dakodako/Group/README.md

# Group

#meeting links

板
https://item.taobao.com/item.htm?id=25225744375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

图像传感器模块
https://item.taobao.com/item.htm?spm=2013.1.0.0.4AKXVt&id=532988877099&ali_refid=a3_430582_1006:1109264529:N:
