dakodako/Group/ESI_WS2.docx

10HZ 9600 Baud rate

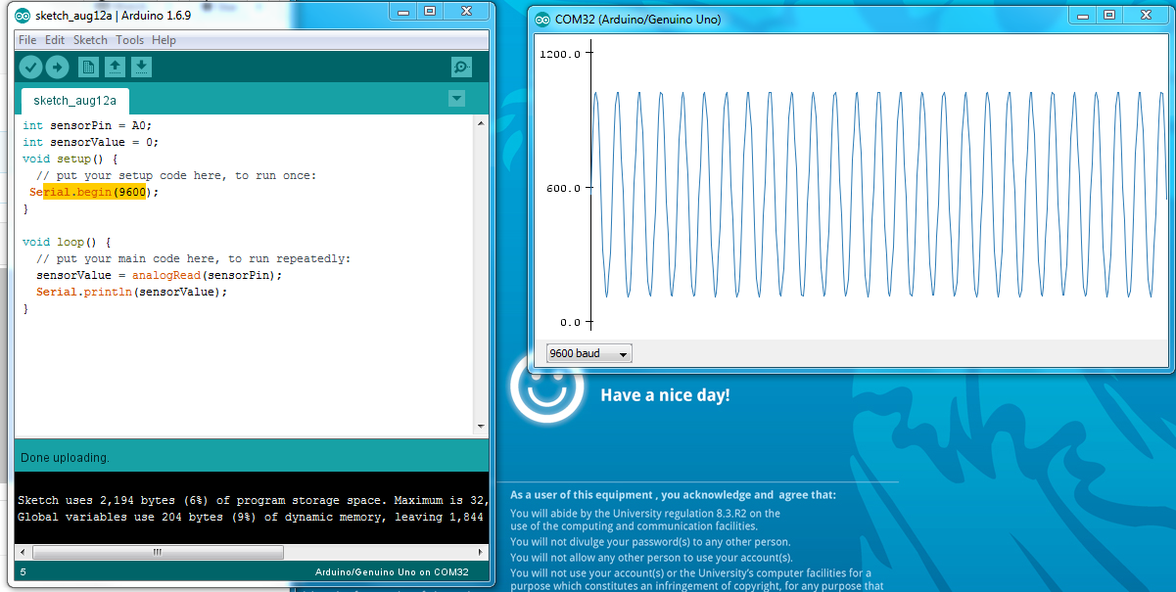
[picture p12: figure]

Function generator increase to 100HZ

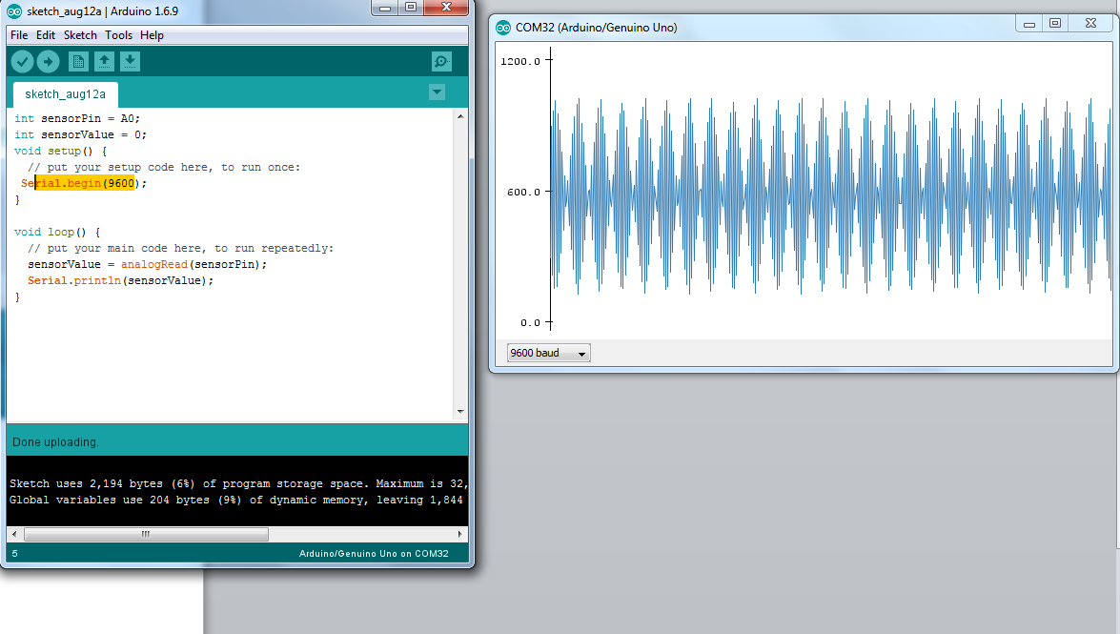
[picture p13: figure]

The plot is becoming inaccurate because the signal has a higher frequency than the resolution

100HZ+115200+4.5_0.5

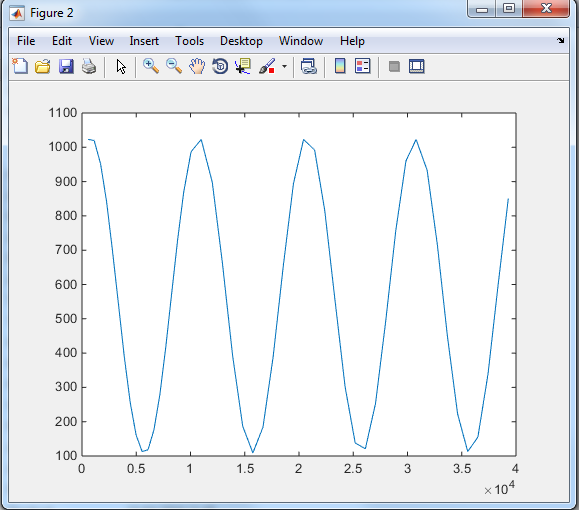
[picture p14: figure]

115200+10HZ+2.05-2.00

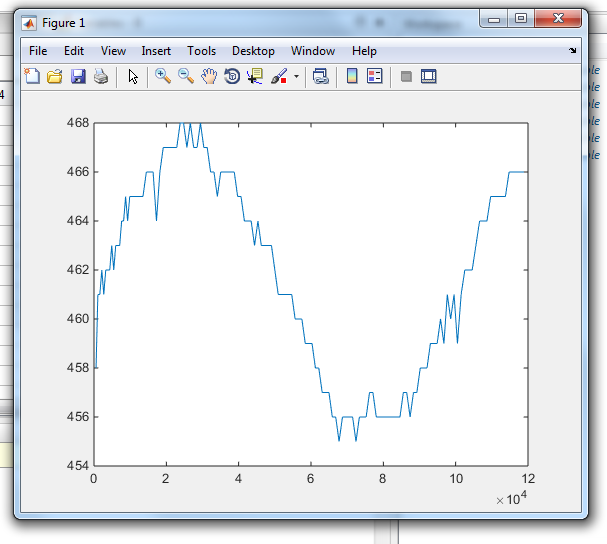
[picture p15: figure]
