dakodako/Group/screen_shots_pdf/workshop5.pdf

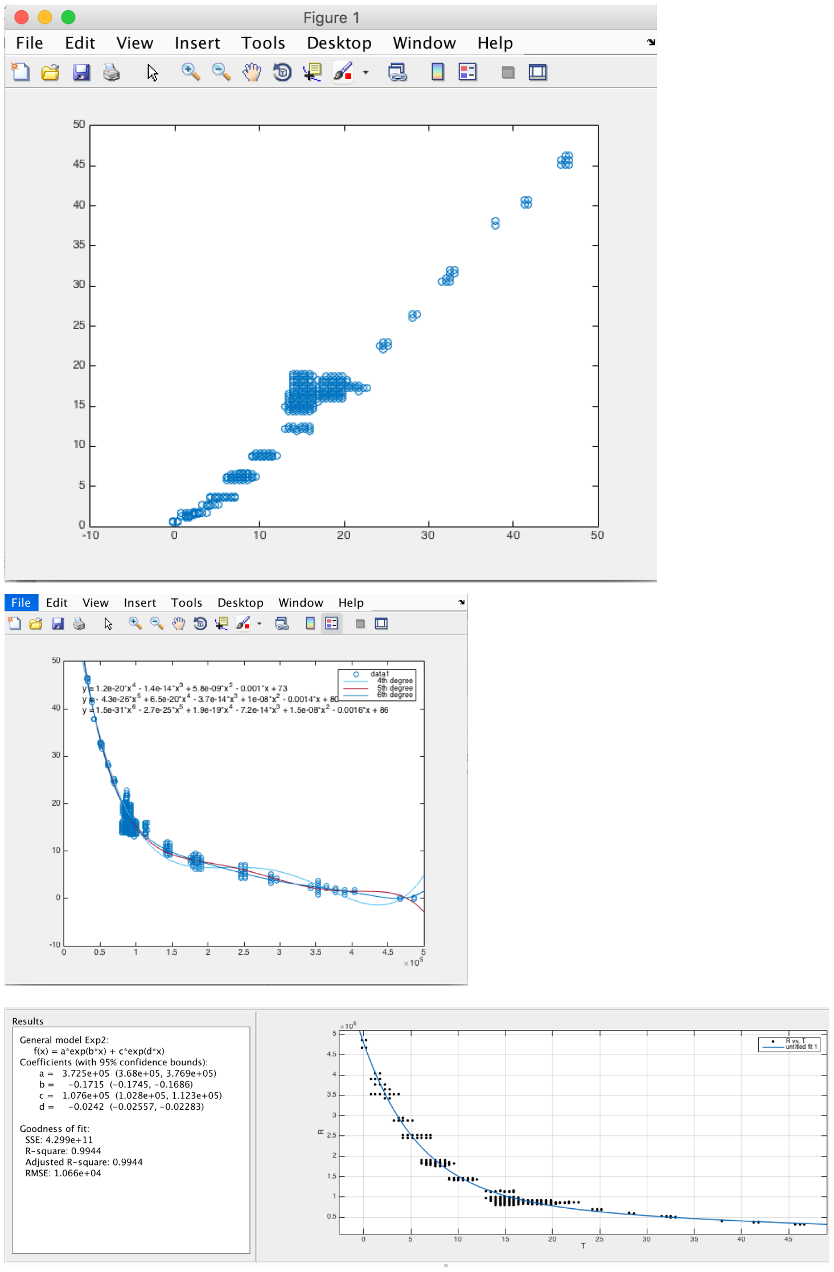
[picture p16: page 1]
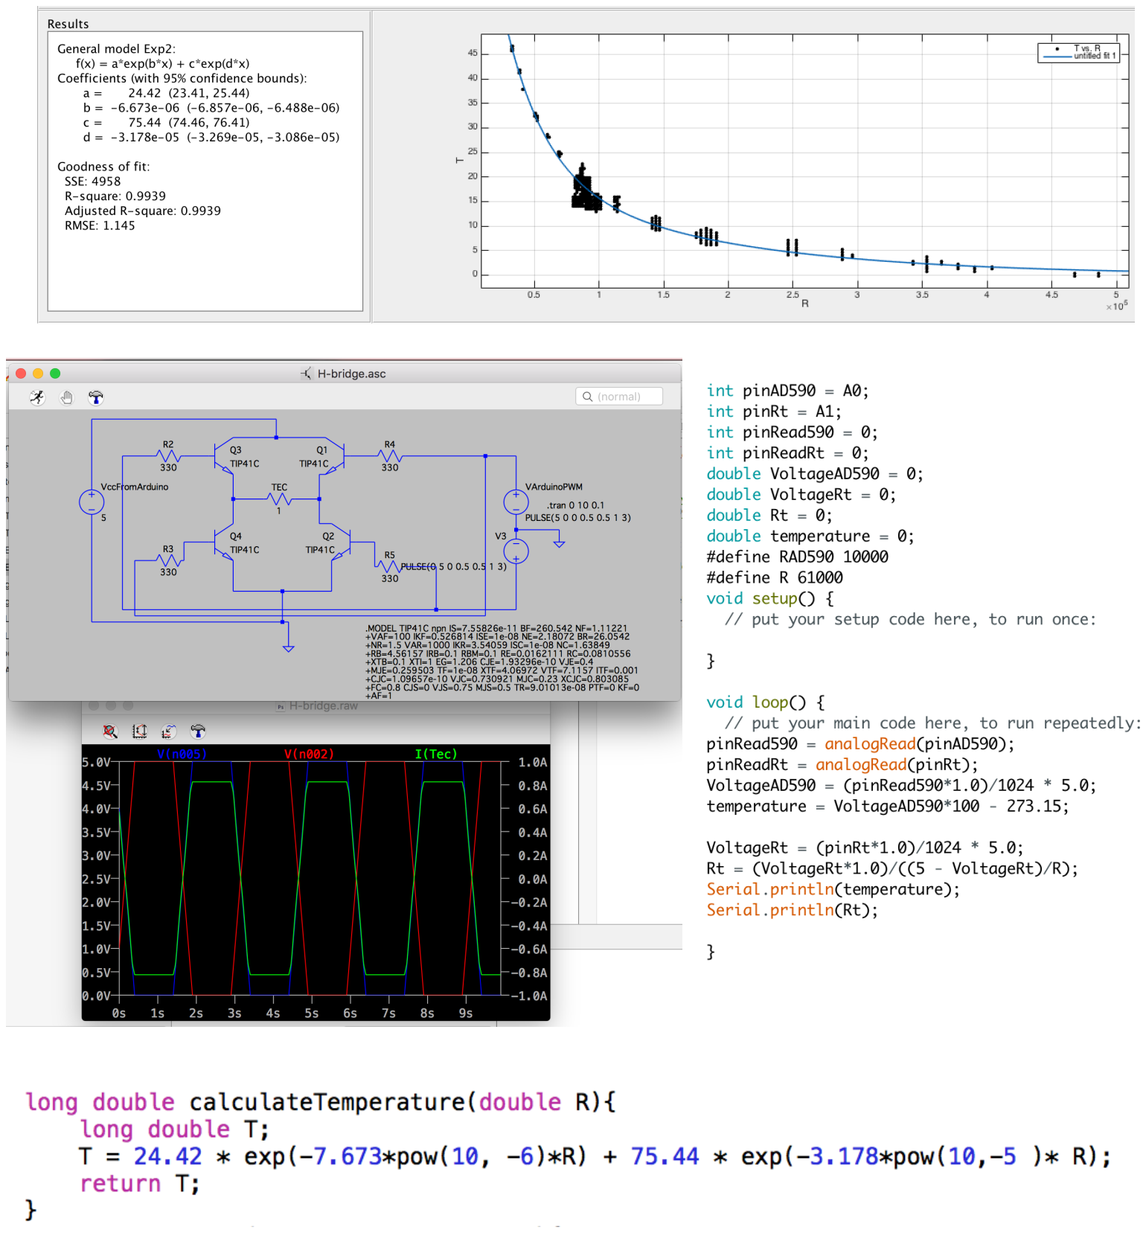
[picture p17: page 2]
