dakodako/Group/2_signal_conditioning/fit/cool_down.PNG

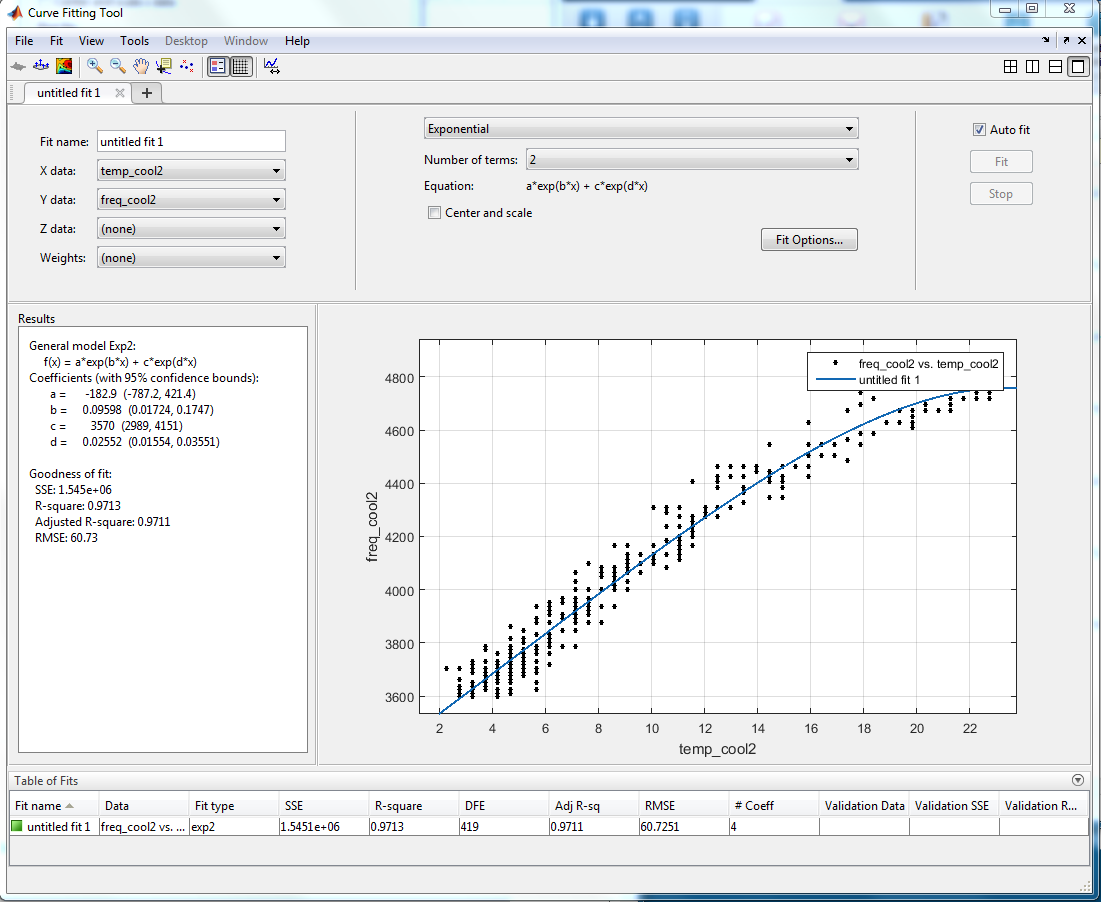
2_signal_conditioning/fit/cool_down.PNG
