dakodako/Group/2_signal_conditioning/fit/cool_down_basic.PNG

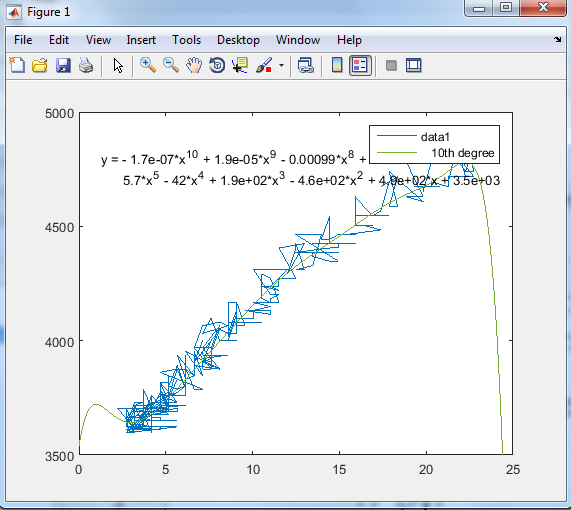
2_signal_conditioning/fit/cool_down_basic.PNG
