dakodako/Group/2_signal_conditioning/fit/heat_up.PNG

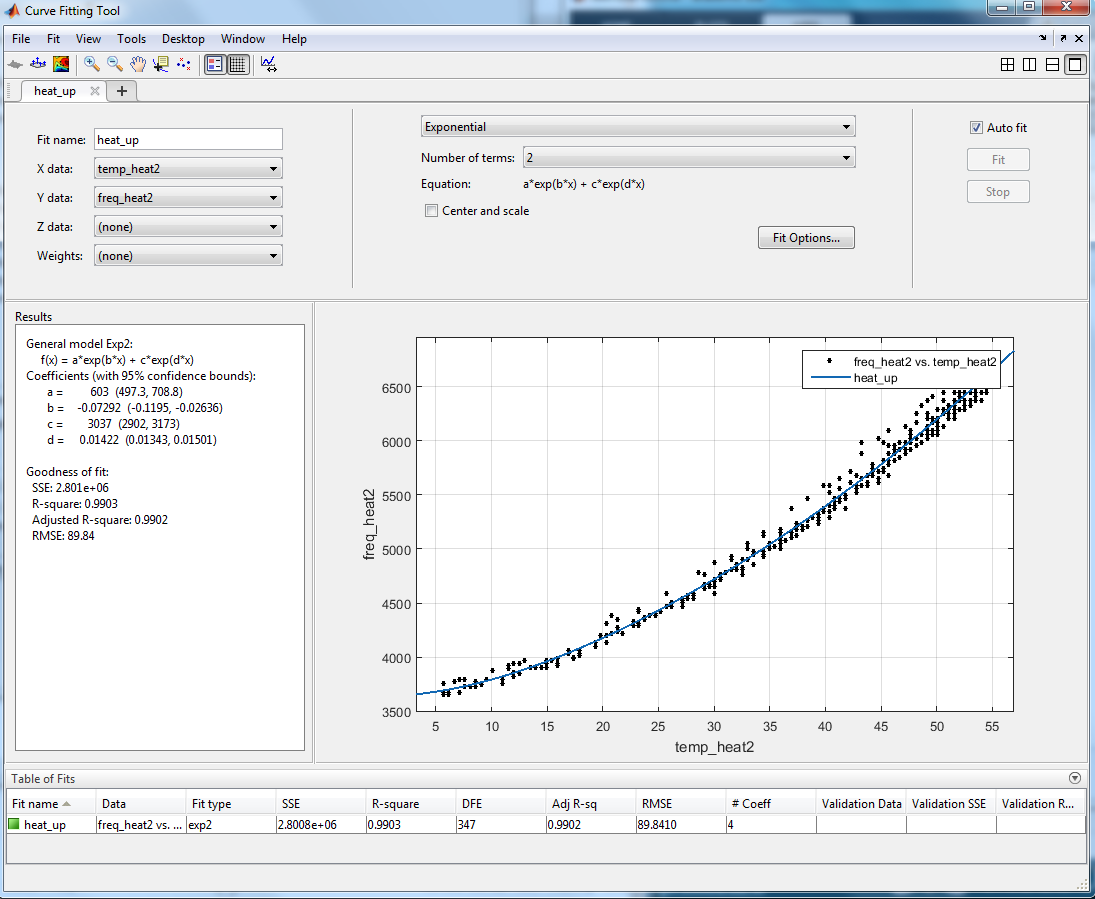
2_signal_conditioning/fit/heat_up.PNG
