dakodako/Group/2_signal_conditioning/fit/heat_up_basic.PNG

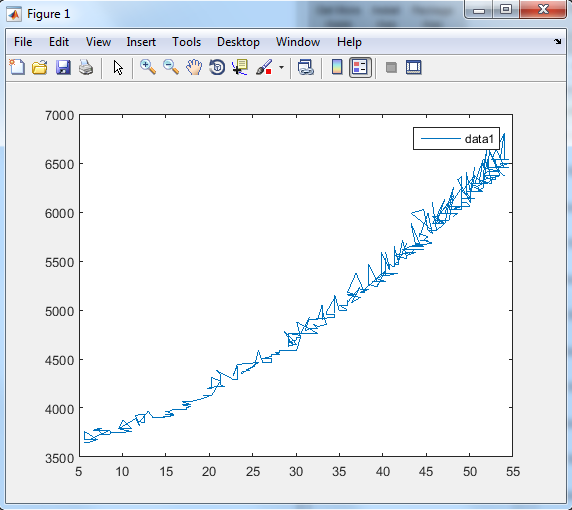
2_signal_conditioning/fit/heat_up_basic.PNG
