dakodako/Group/presentation/ESI_presentation/14793860_10211154600847782_1443315126_n.jpg

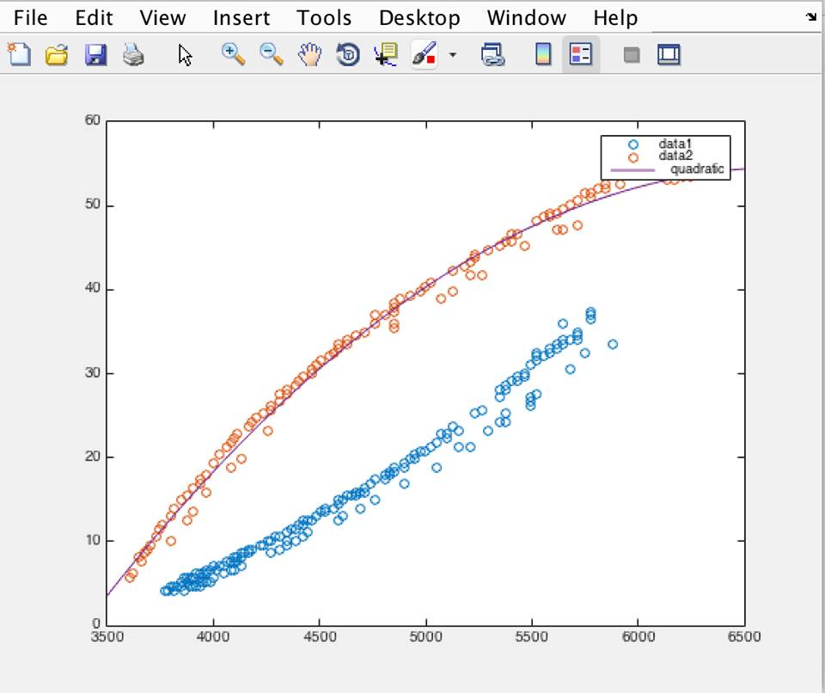
presentation/ESI_presentation/14793860_10211154600847782_1443315126_n.jpg
