dakodako/Group/Screen Shot 2016-09-03 at 10.55.11 PM.png

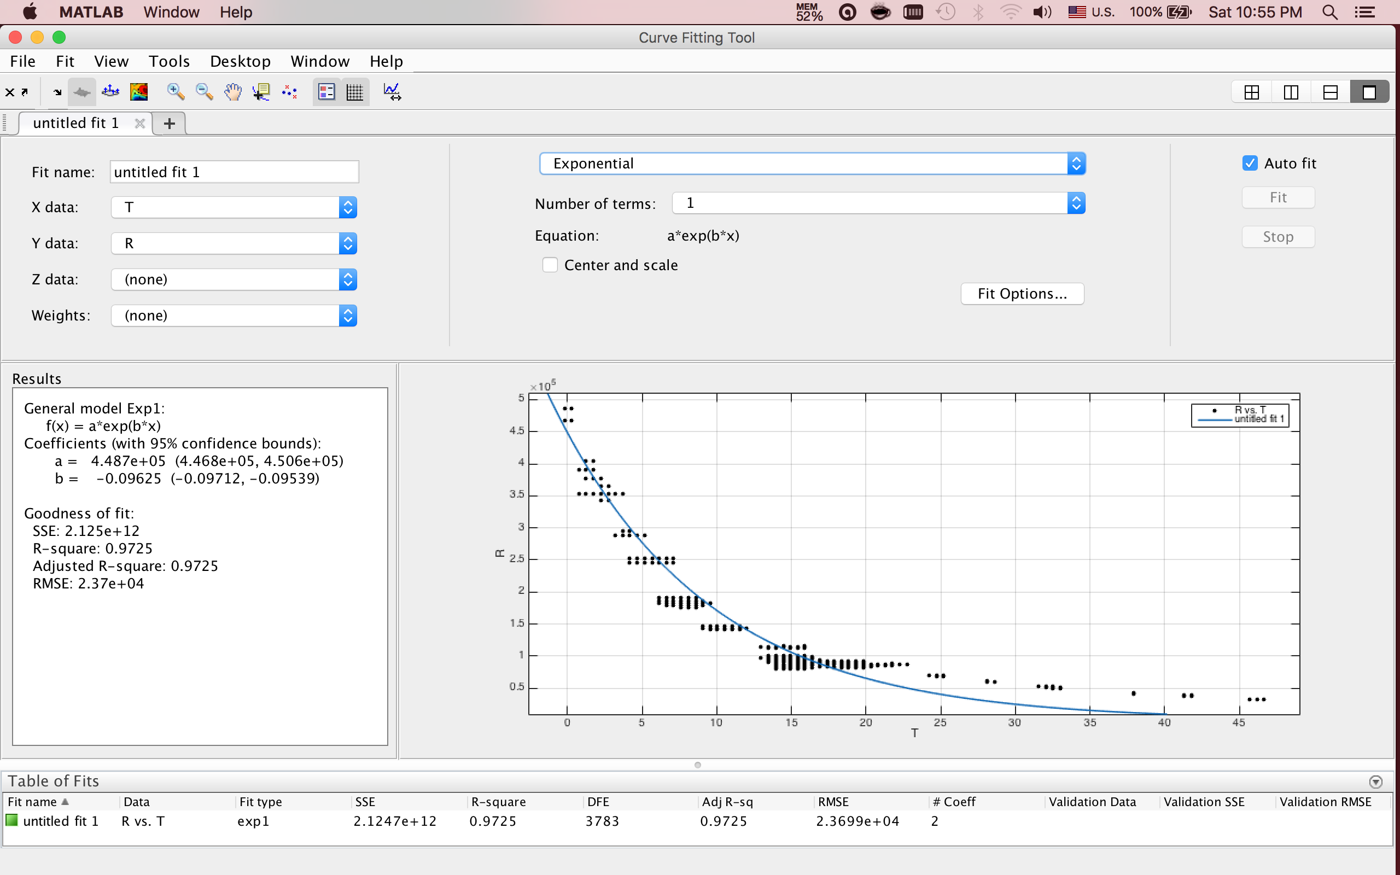
Screen Shot 2016-09-03 at 10.55.11 PM.png
