dakodako/Group/Screen Shot 2016-09-07 at 10.08.42 PM.png

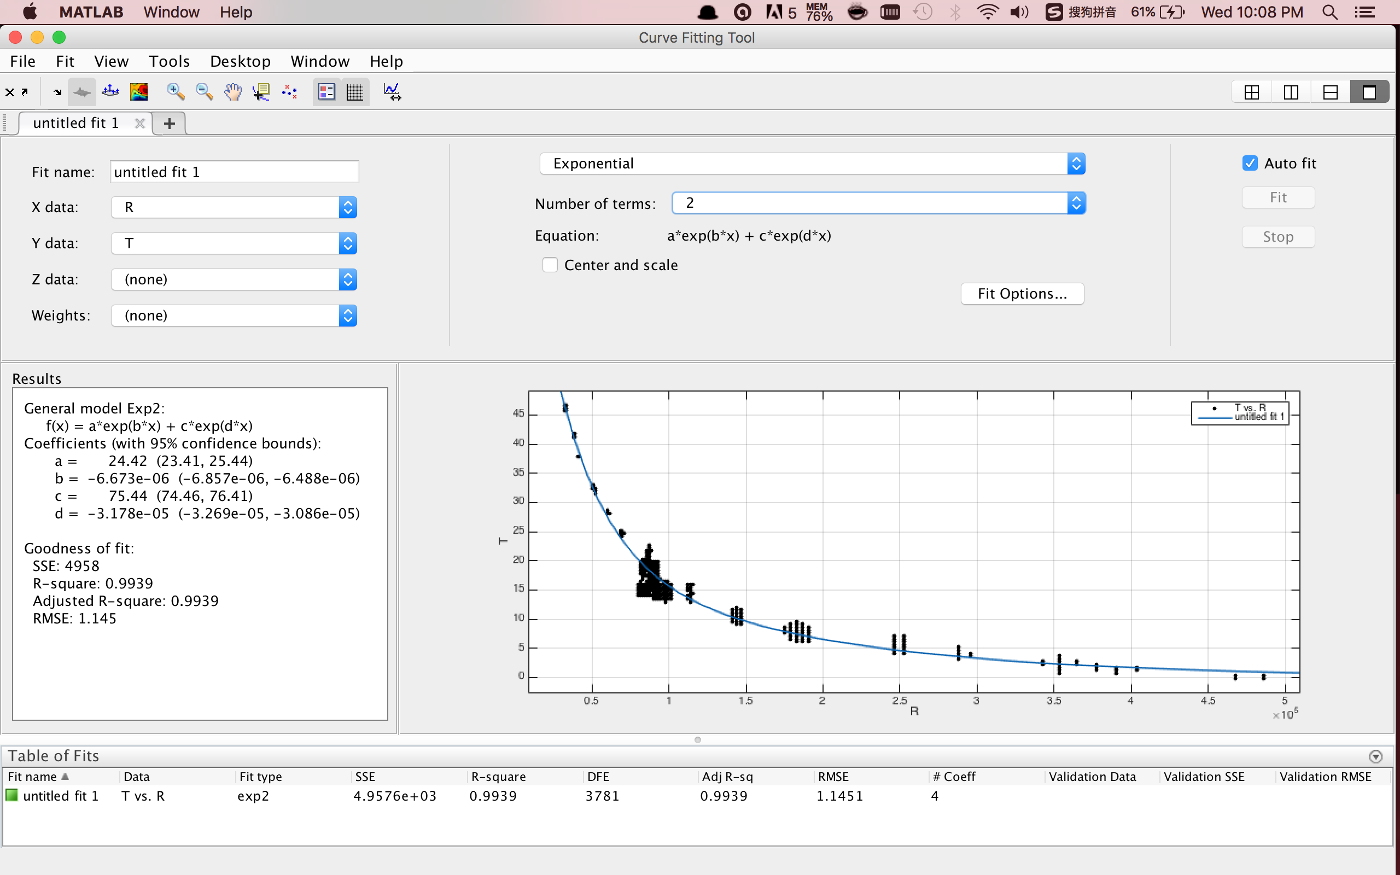
Screen Shot 2016-09-07 at 10.08.42 PM.png
