dakodako/Group/Screen Shot 2016-09-07 at 10.41.13 PM.png

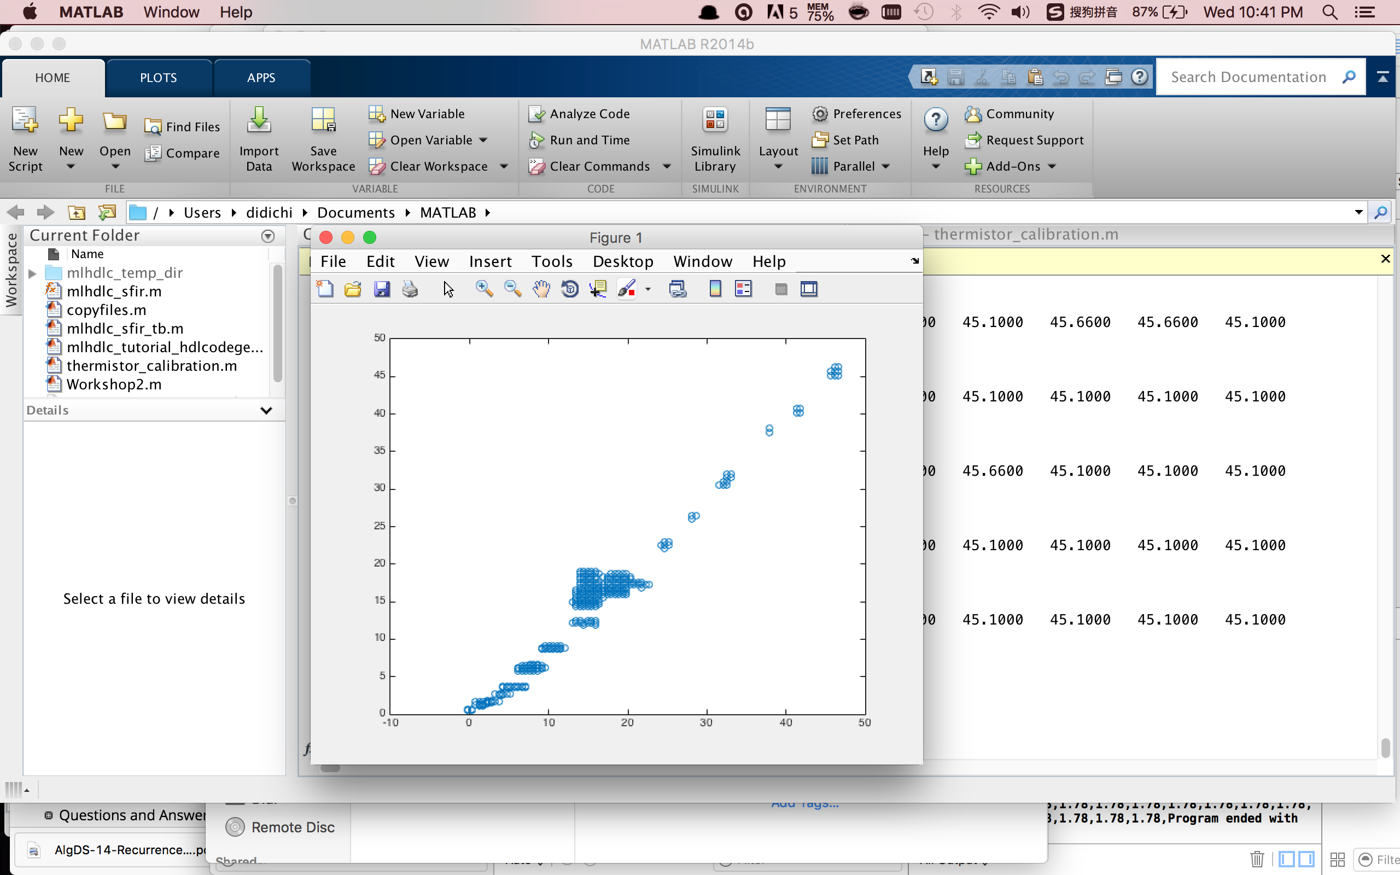
Screen Shot 2016-09-07 at 10.41.13 PM.png
