dakodako/Group/(threads)

Thread 3 (2016-09-22):

Signal_conditioning

xanatower, 2016-09-22:
arduino算出来的频率有200Hz的波动（min-max）， 整个10-8k OHM的区间才1600ohm。

是直接用voltage divider还是555？

dakodako, 2016-09-23:
。。。这个差距有点大吧。要不今天试试wheatstone bridge。。反正有voltage divider做back up了
