dakodako/Group/PhaseShiftOscillator_experiment.asc

C1: cap; 10n
C2: cap; 10n
C3: cap; 10n
C4: cap; 1µ
Q1: npn
R1: res; R = 3.725e+05 * exp(-0.1715*V(temperature) )+ 1.076e+05*exp(-0.0242*V(temperature))
R2: res; 10k
R3: res; 10k
R4: res; 1k
R5: res; 10k
R6: res; 39k
R7: res; 1k
V1: voltage; 5
V2: voltage; 30
Named nets: 0, temperature
.tran 0 2.5 2 0.000001
