dakodako/Group/PhaseShiftOscillator_ideal.asc

C1: cap; 10n
C2: cap; 10n
C3: cap; 10n
C4: cap; 1µ
Q1: npn
R1: res; R = 10000*exp(-14.141963 + 4430.783/V(temperature) - 34078.983/V(temperature)/V(temperature) - 8894192.9/V(temperature)/V(temperature)/V(temperature))
R2: res; 10k
R3: res; 10k
R4: res; 1k
R5: res; 10k
R6: res; 39k
R7: res; 1k
V1: voltage; 5
V2: voltage; PULSE(0 50 2 1 1 2)
V3: voltage; 273.15
Named nets: 0, temperature
.tran 0 2.5 2 0.000001
