dakodako/Group/SPICE for Actuator/DCshiftingapplication.asc

C1: cap; 1µ
C2: cap; 10µ
C3: cap; 10µ
Q1: pnp; BC327-25
R1: res; 10k
R2: res; 3.3k
R3: res; 13k
R4: res; 39k
R5: res; 14k
R6: res; 1k
R7: res; 1k
V1: voltage; 5
V2: voltage; 5
V3: voltage; PULSE(-5 0 0 1.0e-9 1.0e-9 0.9e-3 1.0e-3)
Named nets: 0
.tran 0 1 0 1.0e-3
