dakodako/Group/SPICE_for_ws5/Draft1.asc

C1: cap; 1n
R1: res; 15k
V1: voltage; PULSE(0V 5V 100us 0 0 200us 0.4ms 10)
Named nets: 0
.tran 0 2ms 0 1ns
