dakodako/Group/SPICE_for_ws5/Draft10.asc

Q1: npn; NPN105
Rc: res; 50k
Re: res; 2k
Vcc: voltage; 5
Vi: voltage; 678.14375m
Named nets: 0, Vout
.model npn105 npn(is = 10fA bf = 100 vaf = 100V)
.op
