dakodako/Group/SPICE_for_ws5/Draft13.asc

C1: cap; 92n
C2: cap; 92n
C3: cap; 92n
R1: res; 10k
R2: res; 10k
R3: res; 10k
V1: voltage; SINE(0 5 100 0)
Named nets: 0
.tran 0 1 0 1.0e-3
