dakodako/Group/SPICE_for_ws5/Draft15.asc

R1: res; 100
R2: res; 100
U1: LT1001
V1: voltage; 5
V2: voltage; 5
V3: voltage; 5
Named nets: 0, Vout
.tran 0 10 0.1
