dakodako/Group/SPICE_for_ws5/Draft2.asc

C1: cap; 40n
C2: cap; 10n
R1: res; 250k
Named nets: 0
.tran 0 2ms 0 1ns
