dakodako/Group/SPICE_for_ws5/Draft3.asc

C1: cap; 1
L1: ind; 1
R1: res; 1
R2: res; 1
Rg: res; 1
V1: voltage; SINE(0 10 10)
Named nets: 0, port1, port2, I
.tran 0 10 0 1ms
.step param RLVAR 0.1 10 0.1
