dakodako/Group/SPICE_for_ws5/Draft4.asc

Q1: npn; 2N2222
RB: res; 1k
RE: res; 47
RP: res; 1000k
T1: tline; Td=300n Z0=100
VCC: voltage; 5
VIN: voltage; PULSE(0 5 10n 50n 50n 5000n 1000u 1)
Named nets: 0, Va, Vb
.tran 0 5u 0 10p
