dakodako/Group/SPICE_for_ws5/Draft5.asc

C1: cap; 47µF
D1: diode
L1: ind; 0.01
Q1: npn
R1: res; 100
R2: res; 1000
V1: voltage; PULSE(0 5 0 0 0 0 1/10000)
V2: voltage; 5
Named nets: 0
.tran 0 5u 0 10p
