dakodako/Group/SPICE_for_ws5/Draft6.asc

C1: polcap; 10n
R1: res; 10k
R2: res; 10k
U1: NE555
V1: voltage; 5
Named nets: 0
.tran 10p 1ms
