dakodako/Group/SPICE_for_ws5/Draft7.asc

C1: cap
C2: cap
D1: zener; 1N750
Q1: npn; TIP31C
Q2: npn; BC337-40
R1: res; 100
R3: res; 1K
R4: res; 10
R5: res; 150
U1: opamp2; LM741
V1: voltage; 15
.tran 0 2ms 0 1ns
