dakodako/Group/SPICE_for_ws5/Draft8.asc

Q1: npn; NPN1
R1: res; 10k
V1: voltage; 12
Named nets: 0, ic, ib
.MODEL NPN1 NPN (BF = 150)
.tran 0 100 1 1
