dakodako/Group/SPICE_for_ws5/Draft9.asc

Q1: npn; NPN105
R1: res; 1k
Vcc: voltage; 5
Vi: voltage; 1; Rser=0
Named nets: 0, Vout
.model npn105 npn(is = 10fA bf = 100 vaf = 100V)
.dc Vi 0.1 1 0.01
