dakodako/Group/2_signal_conditioning/ne555astable.asc

C1: cap; 10n
C2: cap; 10n
R1: res; 100k
R2: res; 100k
R3: res; 1000
U1: NE555
V1: voltage; 5
Named nets: 0
.tran 0 1 0 0.1
