dakodako/Group/2_signal_conditioning/freq_EMA/freq_EMA.ino

   
int pin = 7;
int PWM_pin = 3;
int stable_counter=0;
int average_counter=0;
unsigned long int total_frequency=0;
int average_frequency=0;
bool flag = false;

unsigned long duration_high;
unsigned long duration_low;
unsigned long period;
unsigned long frequency;

float EMA_a = 0.6;
int EMA_S = 0;
 
void setup()
{
  pinMode(pin, INPUT);
  Serial.begin (9600);
}

void loop()
{
  duration_high = pulseIn(pin, HIGH);
  duration_low = pulseIn(pin, LOW);
  period = duration_high + duration_low;
  frequency = 1000000/period;
  EMA_S = (EMA_a*frequency) + ((1-EMA_a)*EMA_S);
  delay(1000);
  Serial.println(EMA_S);
  //Serial.println(frequency);
}
