dakodako/Group/(commit log)

2016-08-03 初步完成？
    用模拟器测试过然并卵
2016-08-12 Update and rename 100HZ.txt to 100HZ+11520.txt
2016-08-12 Add files via upload
    add temperature reading
2016-08-14 using arduino as an ohmmeter
2016-08-20 data and plots
    [workshop3data.xlsx]
2016-09-05 PhaseShiftOscillator as temperature sensor
2016-09-05 ne555timer
    using as an actuator to control H bridge
2016-09-07 update readingData with thermistor equation
2016-09-07 thermistor calibration
2016-10-13 Add files via upload
    clone the library first https://github.com/br3ttb/Arduino-PID-Library/
